hamzahossain/OmniNav/README.md

# OmniNav
A smart omnidirectional navigation assistant meant for the visually impaired.

This repository is mainly to log the changes made to the project, keep track of the purchases, have a to-do list and of course store the code.
