hamzahossain/OmniNav/logs/attachments/1.png

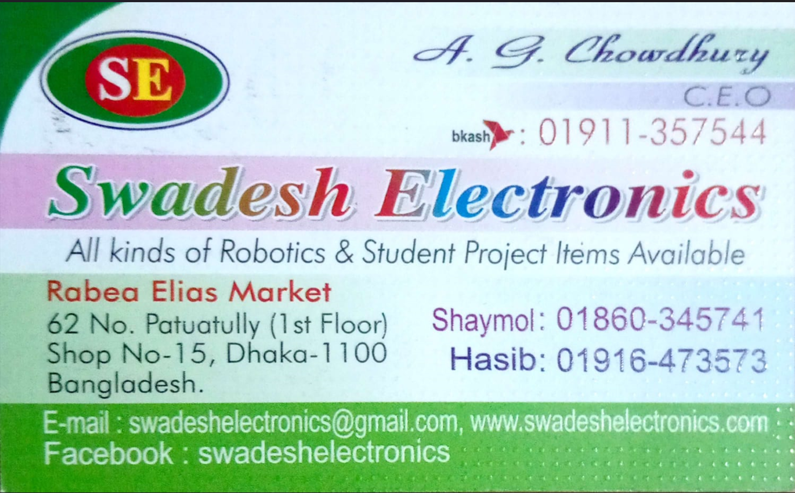
logs/attachments/1.png
