hamzahossain/OmniNav/logs/attachments/2.png

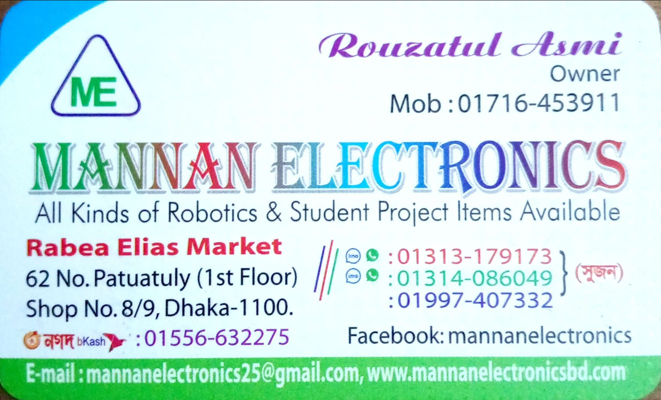
logs/attachments/2.png
