hamzahossain/OmniNav/logs/attachments/4.png

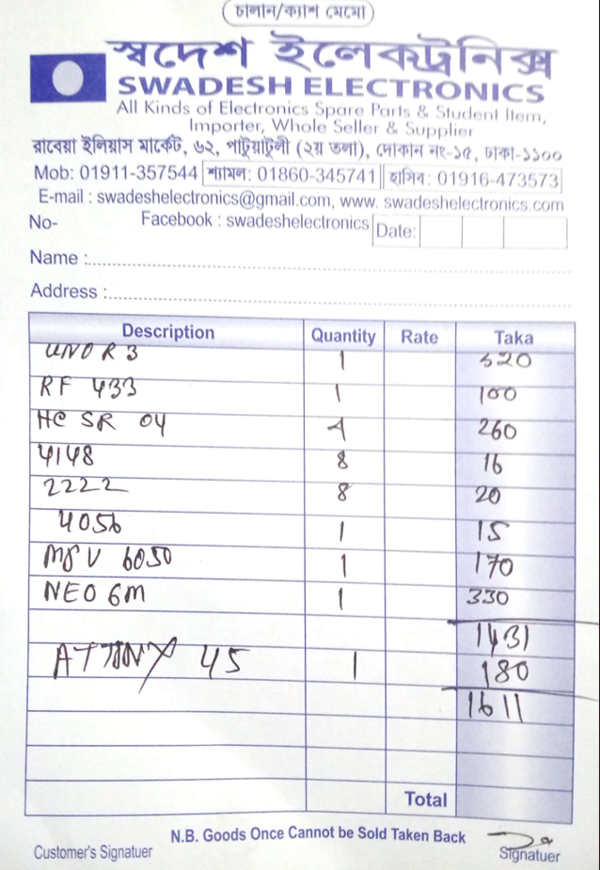
logs/attachments/4.png
