hamzahossain/OmniNav/logs/attachments/5.png

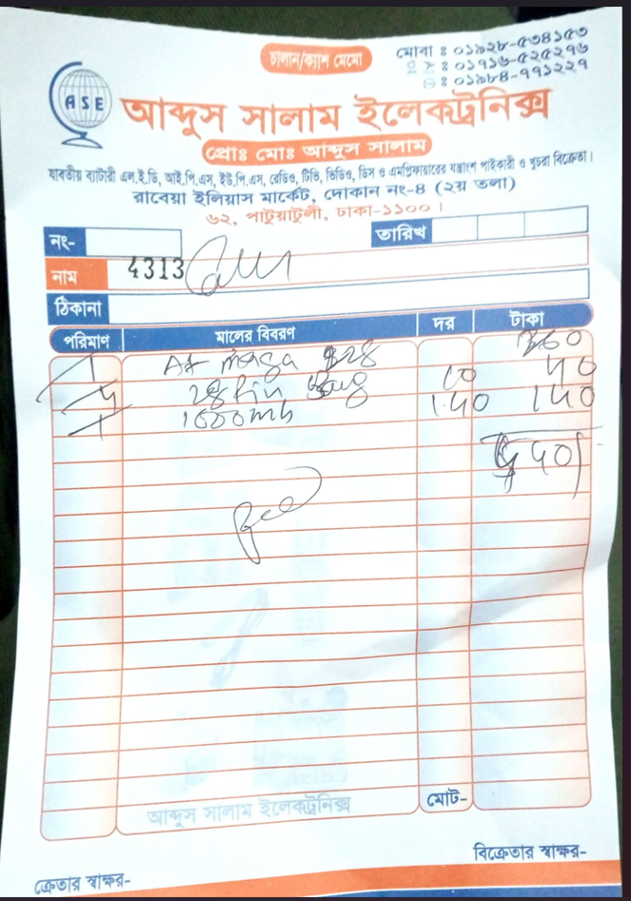
logs/attachments/5.png
