hamzahossain/OmniNav/logs/attachments/15.png

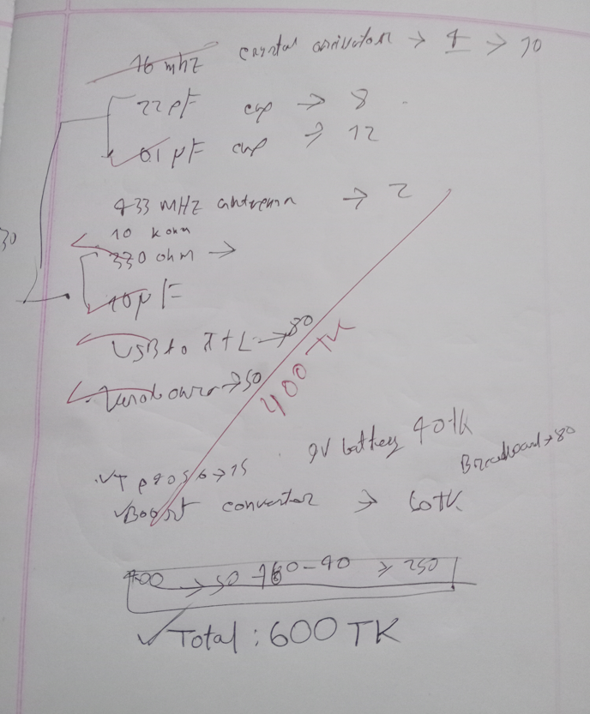
logs/attachments/15.png
