hamzahossain/OmniNav/logs/attachments/16o.png

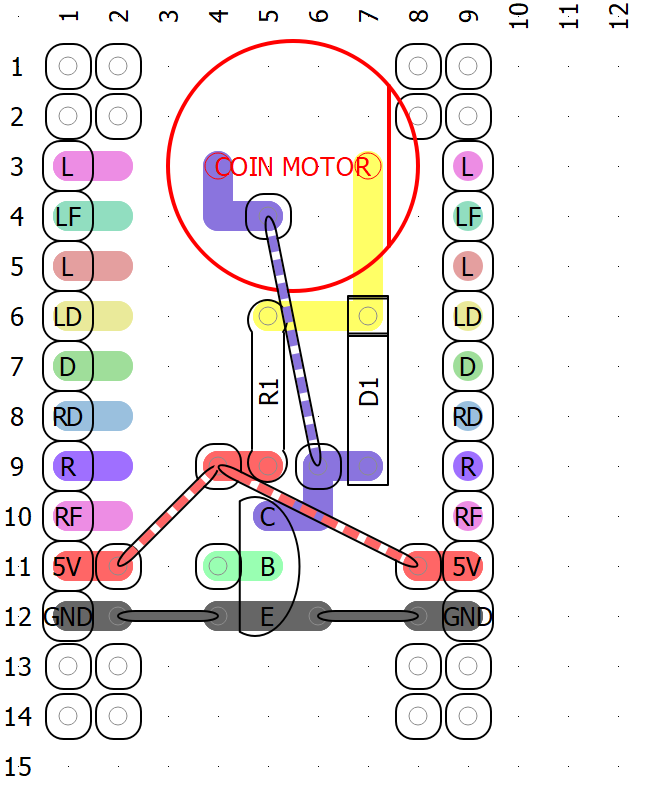
logs/attachments/16o.png
