hamzahossain/OmniNav/logs/attachments/17o.png

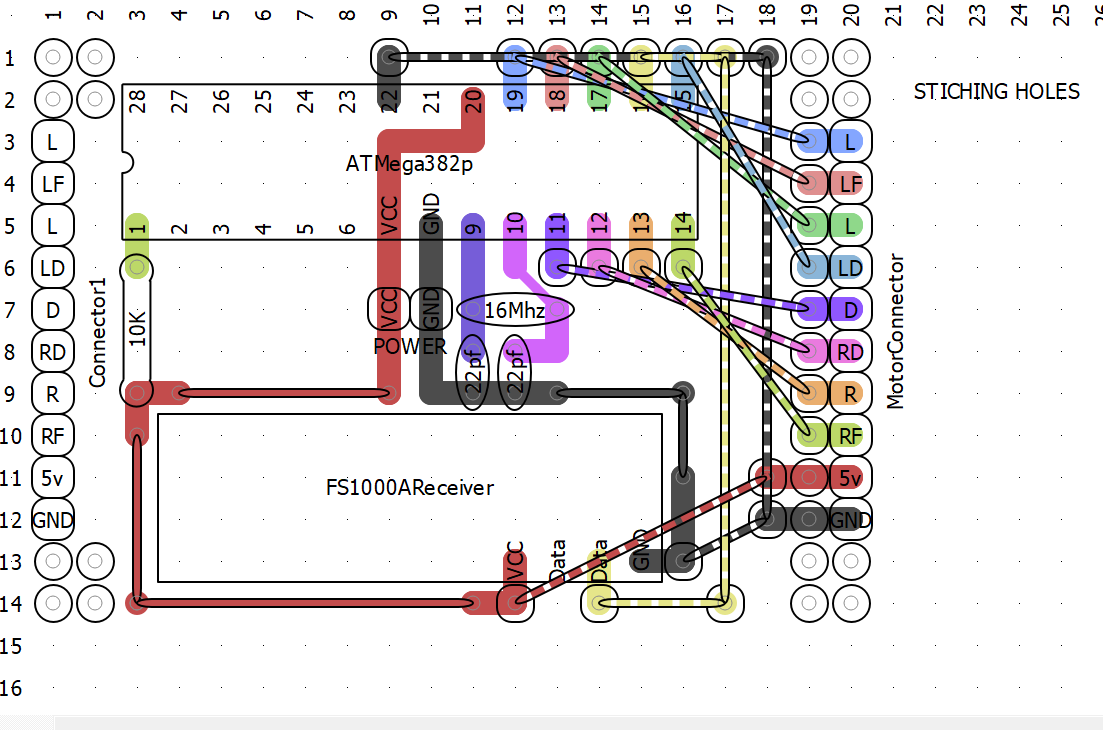
logs/attachments/17o.png
