hamzahossain/OmniNav/logs/attachments/18.jpg

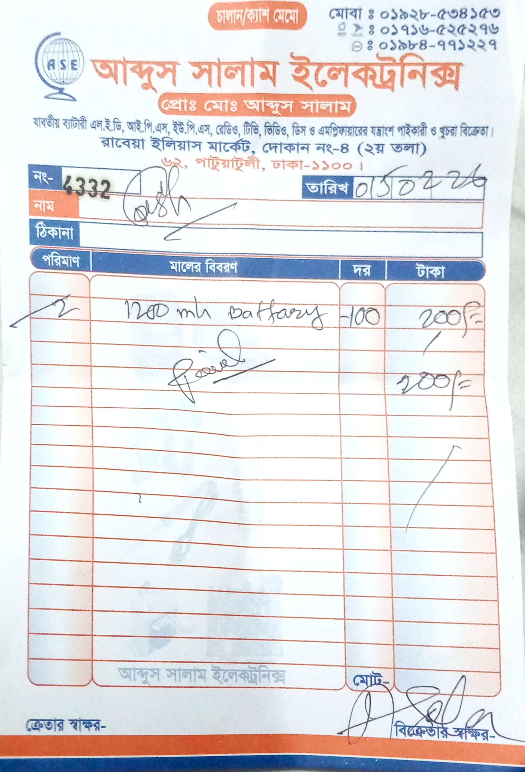
logs/attachments/18.jpg
