hamzahossain/OmniNav/logs/attachments/20.jpg

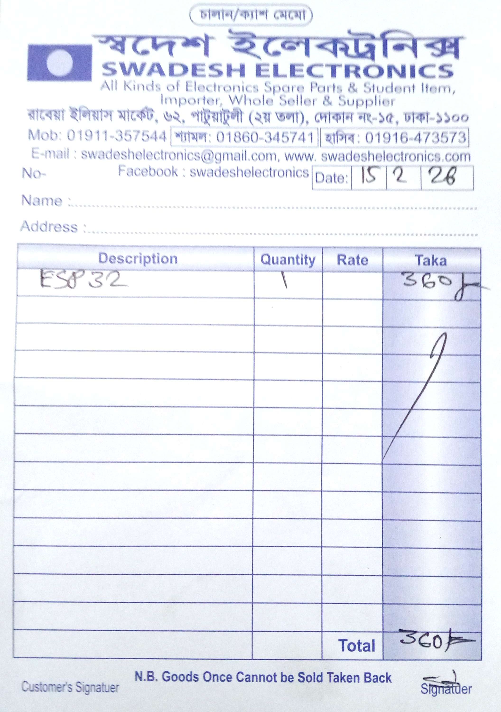
logs/attachments/20.jpg
