hamzahossain/OmniNav/logs/attachments/22.jpg

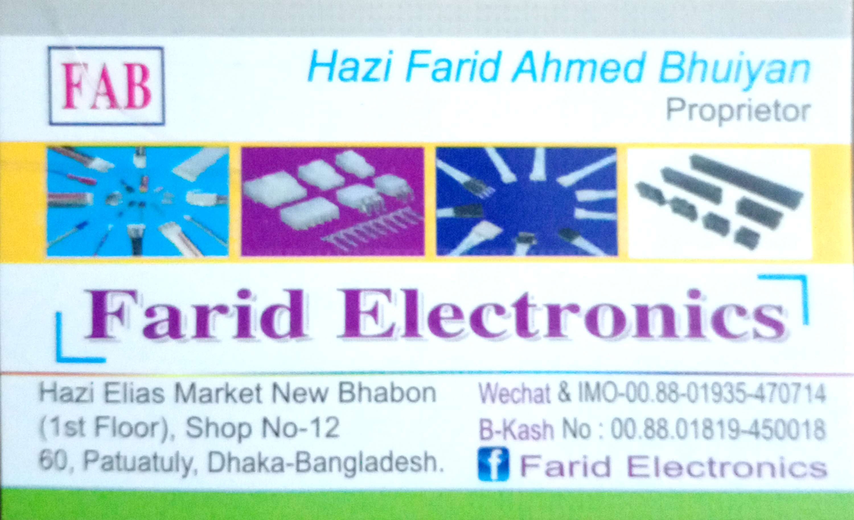
logs/attachments/22.jpg
