hamzahossain/OmniNav/(commit log)

2026-02-06 start vibration motor
2026-02-15 move to esp32
